adadurov/PskOnline.X20.Firmware/hardware/PskOnline.X20.PCB_2019.11.28/pcb_overview.jpg

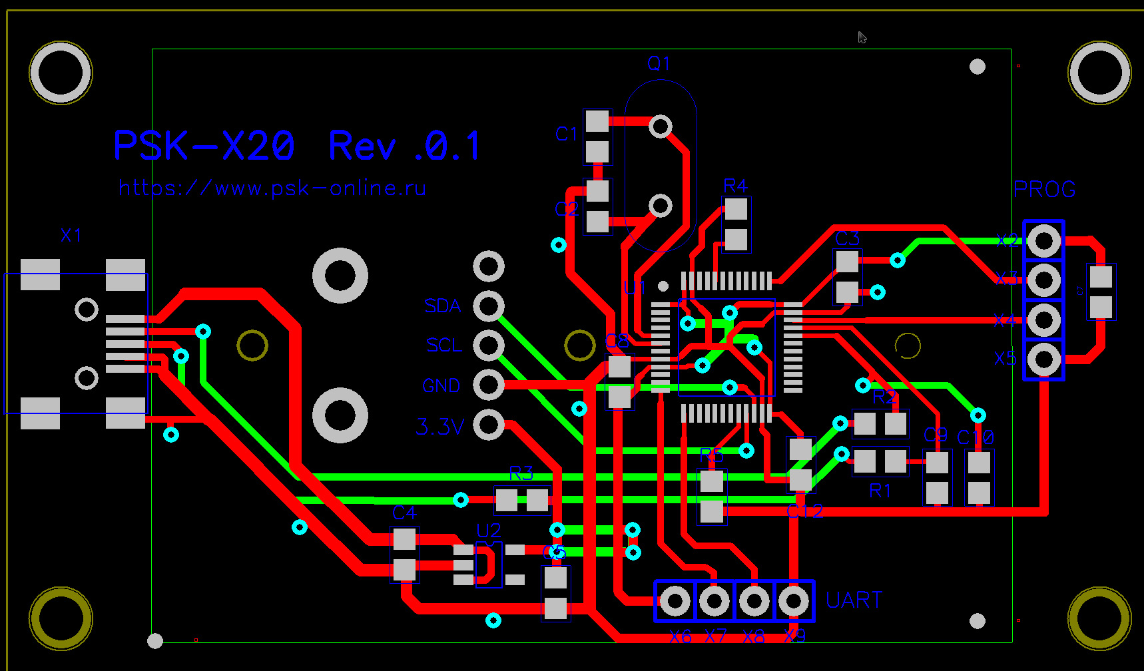
hardware/PskOnline.X20.PCB_2019.11.28/pcb_overview.jpg
