adadurov/PskOnline.X20.Firmware/Src/main.c

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

/* Includes ------------------------------------------------------------------*/
#include "main.h"
#include "usb_device.h"

/* USER CODE BEGIN Includes */
#include "revision.h"
#include "usbd_cdc_if.h"
#include "debug.h"
#include "uuid.h"
#include "revision.h"
#include "psk_x20.h"

#include "I2C_Software_Master.h"

/* USER CODE END Includes */


UART_HandleTypeDef huart2;

/* USER CODE BEGIN PV */

char serialNumber[20];

HX20_SENSOR sensor;

/* USER CODE END PV */

void SystemClock_Config(void);
static void MX_GPIO_Init(void);
static void MX_USART2_UART_Init(void);
/* USER CODE BEGIN PFP */

static void GPIO_Init_USB_Connect(void);
/* USER CODE END PFP */

/* USER CODE BEGIN 0 */

/*************************************************************************
 * Function Name: USB_ConnectRes
 * Parameters: Boolean Conn
 *
 * Return: none
 *
 * Description: Enable Pull-Up resistor
 *
 *************************************************************************/
void USB_ConnectRes (uint8_t Conn)
{
	HAL_GPIO_WritePin( GPIOC, GPIO_PIN_11,((Conn)?GPIO_PIN_RESET:GPIO_PIN_SET));
}

void TraceStartupInfo(void *stackPointer, char *serialNumber, uint16_t usb_package_size)
{
	trace_write_newline();
	trace_write_newline();
	trace_write_newline();

	trace_write_string("PSK-X20 Initializing.................");	                        trace_write_newline();
	trace_write_string("  Version:              ");  trace_write_string(REVISION_INFO);       trace_write_newline();
	trace_write_string("  Built on:             ");  trace_write_string(BUILD_DATE);          trace_write_newline();

	trace_write_string("  Stack started at:     0x");  trace_write_int((uint32_t)stackPointer);	trace_write_newline();
	trace_write_string("  STM32 UUID:           ");  trace_write_string(serialNumber);        trace_write_newline();
}

void TraceStartupReady()
{
	trace_write_newline();
	trace_write_string("PSK-X20 Initialized, ready to rock!");  trace_write_newline();
	trace_write_newline();
}

/* USER CODE END 0 */

/**
  * @brief  The application entry point.
  * @retval int
  */
int main(void)
{
  /* USER CODE BEGIN 1 */
  uint16_t usb_package_size = 0;

  /* USER CODE END 1 */

  /* MCU Configuration--------------------------------------------------------*/

  /* Reset of all peripherals, Initializes the Flash interface and the Systick. */
  HAL_Init();

  /* USER CODE END Init */

  /* Configure the system clock */
  SystemClock_Config();

  /* Initialize all configured peripherals */
  MX_GPIO_Init();
  MX_USART2_UART_Init();

  I2C_SoftWare_Master_Init();

  HAL_GPIO_WritePin(USER_LED_GPIO_Port, USER_LED_Pin, GPIO_PIN_SET);

  trace_write_init(&huart2);
  // needs a buffer of at least 16 bytes
  get_uid_str(serialNumber);

  MX_USB_DEVICE_Init();
  /* USER CODE BEGIN 2 */

  /* USER CODE BEGIN Init */
  const uint16_t max_usb_package_size = 276;

  GPIO_Init_USB_Connect();

  TraceStartupInfo(&usb_package_size, serialNumber, usb_package_size);

  sensor = X20_ConfigureSensor(NULL /*use sw i2c*/, max_usb_package_size, &CDC_FreeToTransmit, &CDC_Transmit_FS, &Error_Handler);
  usb_package_size = X20_GetCapabilities(sensor)->bytes_per_physio_transfer;

  CDC_UseSensor(sensor);

  // Connect USB pull-up so that the USB host detects the connected device
  // Required for OLIMEX STM32-P103 board
  USB_ConnectRes (1);

  TraceStartupReady();

  /* USER CODE END 2 */

  /* Infinite loop */
  /* USER CODE BEGIN WHILE */
  while (1)
  {
    /* USER CODE END WHILE */

    /* USER CODE BEGIN 3 */
	X20_Task(sensor);
  }
  /* USER CODE END 3 */
}


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
/* USER CODE BEGIN 4 */

static void GPIO_Init_USB_Connect(void)
{
  GPIO_InitTypeDef GPIO_InitStruct = {0};

  /*Configure GPIO pin Output Level */
  HAL_GPIO_WritePin(GPIOC, GPIO_PIN_11, GPIO_PIN_RESET);

  /*Configure GPIO pin : USER_LED_Pin */
  GPIO_InitStruct.Pin = GPIO_PIN_11;
  GPIO_InitStruct.Mode = GPIO_MODE_OUTPUT_PP;
  GPIO_InitStruct.Pull = GPIO_NOPULL;
  GPIO_InitStruct.Speed = GPIO_SPEED_FREQ_LOW;
  HAL_GPIO_Init(GPIOC, &GPIO_InitStruct);
}


void HAL_TIM_PeriodElapsedCallback(TIM_HandleTypeDef *htim)
{
}

/* USER CODE END 4 */
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
