adadurov/PskOnline.X20.Firmware/Inc/revision.h

#define BUILD_DATE (__DATE__ " " __TIME__)

// Due to bug AB#295, this string must be at most 30 Latin characters long.
#define REVISION_INFO "0.4.0-alpha"
//#define REVISION_INFO "0.1.0-alpha-a8f44830c601c15961c19599cc0a3d8c0bbfc8e8"
