adadurov/PskOnline.X20.Firmware/(commit log)

2019-10-13 rewritten the main cycle to always retrieve samples from MAX30102
2019-10-15 reduce size of capabilities descriptor (work around a middleware issue)
    [main.c, psk_x20.h, revision.h]
2019-10-15 comment on a known bug; copy user buffer to transfer buffer (when responding to an X20 command)
    [revision.h]
2019-10-19 print more info on startup; add missing include
    [main.c, revision.h]
2019-10-19 add Debug and Release run config files
    [psk.x20.bluepill Run Debug.cfg, psk.x20.bluepill Run Release.cfg]
2019-11-04 changed the representation of version and build date in capabilities descriptor
    [psk.x20.bluepill Run Debug.cfg, psk.x20.bluepill Run Release.cfg]
2019-11-05 I2C2 initialized with clock speed 200.000 (was 100000); some code cleanup
2019-11-07 introduce traces; switch initial output to trace instead of debug
2019-11-17 fix bug in FIFO implementation
    [ring_buffer.c, ring_buffer.h]
2019-11-29 AB#106 don't flash the LED during measurement
2019-11-29 read die temperature and dump to console
2019-11-29 support die temperature
2019-11-30 Revert "Merge branch 'die_temp'"
    This reverts commit 979dc4b684c2634011ec4acb91e4222aa9cbdd4d, reversing
    changes made to 31d26c5b17dfe40803cea87836b7e9a1b9a2770a.
    [main.c, max30102.c, max30102.h, psk_x20.h, revision.h]
2019-12-13 refactor to simplify porting to other STM32 hardware
2019-12-14 research; try to use high-prio USB interrupt; temporarily disable PPG (only ramp)
    [PskOnline.X20.Firmware Run (1).cfg]
2019-12-15 pass fatal error handler to PSK module;
    [main.c, psk_x20.c, psk_x20.h]
2019-12-16 AB#169 - apply fix to STM USB ISR code; switch back to simple 32-bit transfer; remove debug output & prettify output on startup
    [main.c, psk_x20.c, psk_x20.h]
2019-12-17 AB#179 remove dependency of sensor code on some USB string descriptor indexes; fix naming
    [psk_x20.c, psk_x20.h]
2019-12-26 Add PCB files
2020-01-09 AB#250 change VID & PID as assigned by pid.codes team
2020-01-13 add BluePill wiring tale to README.md
2020-01-14 AB#262 fix bcdDevice in device descriptor
2020-02-02 add code for debugging the issue
    [debug_usb.h, revision.h]
2020-02-09 AB#309 - disable TIM4; change to i2c1; dump content of '0-byte' setup packet
2020-02-11 start adding software I2C (based on GitHub JerrysGit/STM32F411_SoftwareI2C)
2020-02-13 Software I2C: remove test routines; hide internal routines
2020-02-14 use software I2C to read FIFO
2020-02-14 reduce delays in I2C communications; add conditional debug traces; clean up the remains of HAL_I2C_* calls
2020-02-15 switch software I2C to pins B10 & B11; update prototype connections table
2020-08-31 added power consumption info
2020-08-31 fix consumed power in configuration descriptor
2022-08-19 README.md. Added IR pass filter to BOM
